kani7/USBKBD2X68K/(threads)

Thread 1 (2024-03-24):

Gerber files, BOM?

carlosbragatto, 2024-03-24:
Hi Kani7

I would like to attempt building you version of this adapter, having built previously both Mr. Tanaken's and Mr. Zato's.

Would you mind sharing the Gerber files so I can make a LED board like yours? If you could share the Bill of Materials (BOM) I would appreciate it.

Thanks in advance

Closed 2024-03-25.
