kani7/USBKBD2X68K/tvcode.h

/* X68kキーコード ==> テレビコントロール信号への変換テーブル */
const uint8_t tvtable[] PROGMEM = {
    0x00, 0x00, 0x00, 0x00, 0x00, 0x00, 0x00, 0x00, // 00h-07h
    0x00, 0x00, 0x00, 0x00, 0x00, 0x00, 0x00, 0x00, // 08h-0Fh
    0x00, 0x00, 0x00, 0x00, 0x00, 0x00, 0x00, 0x00, // 10h-17h
    0x00, 0x00, 0x00, 0x00, 0x00, 0x00, 0x00, 0x00, // 18h-1Fh
    0x00, 0x00, 0x00, 0x00, 0x00, 0x00, 0x00, 0x00, // 20h-27h
    0x00, 0x00, 0x00, 0x00, 0x00, 0x00, 0x00, 0x00, // 28h-2Fh
    0x00, 0x00, 0x00, 0x00, 0x00, 0x00,             // 30h-35h
    0x00,   // 36h HOME     []
    0x0e,   // 37h DEL      電源ON/OFF
    0x00,   // 38h R_UP     []
    0x00,   // 39h R_DOWN   []
    0x00,   // 3Ah UNDO     []
    0x0c,   // 3Bh カーソル左   チャンネルDOWN
    0x01,   // 3Ch カーソル上   音量アップ
    0x0b,   // 3Dh カーソル右   チャンネルUP
    0x02,   // 3Eh カーソル下   音量ダウン
    0x04,   // 3Fh CLR      チャンネルコール
    0x19,   // 40h Num /    チャンネル10
    0x1a,   // 41h Num *    チャンネル11
    0x1b,   // 42h Num -    チャンネル12
    0x16,   // 43h Num 7    チャンネル7
    0x17,   // 44h Num 8    チャンネル8
    0x18,   // 45h Num 9    チャンネル9
    0x0f,   // 46h Num +    スーパーインポーズON/OFF、コントラストダウン
    0x13,   // 47h Num 4    チャンネル4
    0x14,   // 48h Num 5    チャンネル5
    0x15,   // 49h Num 6    チャンネル6
    0x09,   // 4Ah Num =    テレビチューナ/外部入力切り替え
    0x10,   // 4Bh Num 1    チャンネル1
    0x11,   // 4Ch Num 2    チャンネル2
    0x12,   // 4Dh Num 3    チャンネル3
    0x00,   // 4Eh Num ENT  []
    0x06,   // 4Fh Num 0    ミュート
    0x03,   // 50h Num ,    ボリュームノーマル
    0x08,   // 51h Num .    TV/コンピュータ画面切り替え
                0x00, 0x00, 0x00, 0x00, 0x00, 0x00, // 52h-57h
    0x00, 0x00, 0x00, 0x00, 0x00, 0x00, 0x00, 0x00, // 58h-5Fh
    0x00, 0x00, 0x00, 0x00, 0x00, 0x00, 0x00, 0x00, // 60h-67h
    0x00, 0x00, 0x00, 0x00, 0x00, 0x00, 0x00, 0x00, // 68h-6Fh
    0x00, 0x00, 0x00, 0x00, 0x00, 0x00, 0x00, 0x00, // 70h-77h
    0x00, 0x00, 0x00, 0x00, 0x00, 0x00, 0x00, 0x00  // 78h-7Fh
};
