kani7/USBKBD2X68K/(commit log)

2023-10-09 Update README.md
    黒キーボードでの動作未確認である旨を削除。
    つまり、動作に支障無い事を確認した。
2023-10-09 Update BUGS.md
    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
